franck18/spacefarm/SpaceFarm_RaspberryPi_Dashboard.docx

WORKSHOP HORIZON 2080 · PILIER 2 FOODTECH & AGRITECH

SpaceFarm 2080

Le Raspberry Pi et le tableau de bord

Ce document explique en détail la partie « serveur et affichage » du prototype : comment le Raspberry Pi reçoit, vérifie, enregistre et exploite les mesures de la serre, puis comment le tableau de bord web les présente et permet de piloter l'éclairage.

Il est écrit pour être compris sans connaître le code : chaque notion technique est expliquée simplement, puis illustrée par le vrai fonctionnement du programme.

Périmètre présenté

Mesures réelles : température et humidité de l'air (DHT11), luminosité relative (photorésistance), niveau d'eau (sonde).

Commande réelle : la LED d'éclairage, en automatique ou en manuel.

Simulation uniquement : les trois cultures, leurs besoins en eau et le scénario de crise « Survival Mode ».

Reporté après le rendu : l'irrigation par pompe (le tuyau arrive après la date de rendu).

EPSI Bachelor 3 · Septembre 2026

Sommaire

Si le sommaire est vide : clic droit dessus puis « Mettre à jour les champs ».

# 1. Vue d'ensemble

## 1.1 Le rôle du Raspberry Pi et du tableau de bord

Le prototype SpaceFarm est composé de trois éléments qui travaillent ensemble. Une image simple aide à comprendre qui fait quoi :

Élément | Image simple | Ce qu'il fait réellement
Arduino Yún | Les yeux et les mains | Lit les capteurs toutes les 2 secondes environ, envoie les valeurs au Pi par Wi-Fi et allume ou éteint la LED quand le Pi le demande.
Raspberry Pi 3 | La mémoire et le cerveau | Reçoit les mesures, les vérifie, les enregistre dans une base de données, déclenche les alertes, décide de l'éclairage et héberge le site web.
Tableau de bord | L'écran de contrôle | Page web ouverte dans un navigateur : affiche les mesures, les courbes, les alertes et l'état du Pi, et permet de commander la LED.

Ma partie couvre le Raspberry Pi (le programme serveur écrit en Python et la base de données SQLite) et le tableau de bord (le site écrit en React et TypeScript).

## 1.2 Le chemin complet d'une mesure

1. Le capteur produit une valeur électrique ; l'Arduino Yún la lit.
2. La Yún regroupe toutes ses mesures dans un petit message texte au format JSON et l'envoie au Pi par Wi-Fi (POST /api/ingest).
3. Le Pi vérifie le message, enregistre chaque mesure dans SQLite et regarde si une alerte doit être créée.
4. Le Pi décide si la LED doit changer d'état et glisse l'ordre éventuel dans sa réponse à la Yún.
5. Dans le navigateur, le tableau de bord demande l'état complet au Pi toutes les 3 secondes (GET /api/state).
6. Le tableau de bord vérifie la réponse, puis met à jour les cartes, les courbes et le journal.

Point clé

Tout fonctionne en réseau local, sans Internet ni service cloud. C'est essentiel dans le contexte du sujet : un vaisseau spatial ne peut pas compter sur une connexion permanente avec la Terre.

## 1.3 Pourquoi deux cartes plutôt qu'une seule ?

- La Yún est faite pour lire des broches électriques (capteurs) et piloter des sorties (LED). Elle a très peu de mémoire.
- Le Pi est un vrai petit ordinateur sous Linux : il peut stocker des jours de mesures, faire tourner un serveur web et calculer des statistiques.
- Chacun fait ce qu'il fait le mieux. Le navigateur ne lit jamais directement les capteurs : il passe toujours par le Pi.

# 2. Le Raspberry Pi

## 2.1 Le matériel et le système

Élément | Valeur
Modèle | Raspberry Pi 3 Model B Rev 1.2
Système | Raspbian GNU/Linux 11 (bullseye)
Réseau | Wi-Fi du lycée ; adresse vérifiée 192.168.41.88 (attribuée par DHCP, elle peut changer)
Port du service | 8000 — adresse du site : http://192.168.41.88:8000/
Emplacement du code | /home/pi/spacefarm/backend/ (serveur) et /home/pi/spacefarm/frontend/dist/ (site compilé)
Base de données | /var/lib/spacefarm/spacefarm.db

## 2.2 Organisation du code du serveur

Le serveur est écrit en Python avec uniquement la bibliothèque standard : http.server pour le web et sqlite3 pour la base. Aucun framework (comme Flask ou Django) n'est nécessaire, ce qui rend l'installation très simple et le programme léger pour un Raspberry Pi 3.

Fichier | Lignes | Rôle
server.py | 54 | Point de départ : lit les options, prépare la base, lance la purge automatique et démarre le serveur web.
routes.py | 272 | Reçoit toutes les requêtes HTTP et choisit quoi faire selon l'adresse demandée. Construit aussi l'état complet envoyé au site.
db.py | 402 | Tout ce qui touche à la base : vérification des mesures, enregistrement, alertes, historique, purge.
automation.py | 72 | Décision automatique de la LED et gestion du mode automatique / manuel.
commands.py | 109 | File d'attente des ordres envoyés à la Yún, avec expiration et accusé de réception.
calibration.py | 30 | Conversion des valeurs brutes des capteurs (0 à 1023) en pourcentages.
system_info.py | 36 | Lecture de l'état du Pi : température du processeur, mémoire, durée de fonctionnement.
spacefarm.service | — | Fichier de configuration pour que Linux démarre le serveur tout seul.
test_*.py | 400 | 31 tests automatiques du serveur.

## 2.3 Le démarrage automatique avec systemd

systemd est le gestionnaire de services de Linux : c'est lui qui lance les programmes au démarrage de la machine. Le fichier spacefarm.service lui indique comment lancer SpaceFarm :

ExecStart=/usr/bin/python3 -B /home/pi/spacefarm/backend/server.py --host 0.0.0.0 --port 8000

User=pi

Restart=on-failure

RestartSec=5

StateDirectory=spacefarm

ProtectSystem=strict

ProtectHome=read-only

- Démarrage automatique : dès que le Pi est allumé et le réseau prêt, le serveur démarre, sans que personne ait besoin de taper une commande.
- Redémarrage en cas de panne : si le programme plante, systemd le relance au bout de 5 secondes (Restart=on-failure).
- Utilisateur limité : le service tourne sous l'utilisateur pi, pas en administrateur.
- Protection du système : le service ne peut écrire que dans son propre dossier /var/lib/spacefarm. Le reste du système et le dossier personnel sont en lecture seule pour lui.
- --host 0.0.0.0 signifie « accepter les connexions venant du réseau », pas seulement du Pi lui-même. C'est ce qui permet à la Yún et aux navigateurs de le joindre.

## 2.4 Les réglages du serveur

Au lancement, server.py accepte plusieurs options. Les valeurs par défaut utilisées sont les suivantes :

Option | Valeur | Signification
--port | 8000 | Port d'écoute du serveur web.
--db | /var/lib/spacefarm/spacefarm.db | Fichier de la base SQLite.
--stale | 120 s | Au-delà de 2 minutes sans nouvelle valeur, une mesure est considérée comme indisponible.
--retention | 7 jours | Durée de conservation des mesures.
--history-hours | 6 h | Durée de l'historique envoyé au tableau de bord.
--reservoir | 0,05 L | Capacité configurée du réservoir (50 mL), utilisée pour estimer un volume.
--token | vide | Mot de passe optionnel exigé de la Yún. Vide = pas de contrôle (voir limites).

Le serveur est multithread (ThreadingHTTPServer) : il peut répondre à la Yún et à plusieurs navigateurs en même temps sans que l'un bloque l'autre.

## 2.5 La réception d'une mesure, étape par étape

Environ toutes les 2 secondes, la Yún envoie ce message au Pi (valeurs réelles relevées le 24 septembre 2026) :

POST /api/ingest

{ "sensor": "spacefarm-yun",

"ack": 0,

"readings": {

"temperature": 23.9,

"humidity": 58,

"light_raw": { "value": 481, "unit": "ADC" },

"water_raw": { "value": 0, "unit": "ADC" },

"lighting": 0 } }

La fonction _receive_measurements() de routes.py traite ce message dans cet ordre :

1. Lire le message (_read_json) : le message doit être du JSON valide et ne pas dépasser 64 Ko.
2. Vérifier l'autorisation (_authorised) : si un jeton est configuré, il doit correspondre. Aujourd'hui aucun jeton n'est configuré.
3. Vérifier le contenu (db.parse_payload) : nom du capteur, liste des mesures, valeurs numériques et plausibles.
4. Enregistrer (db.store_readings) : une ligne par mesure dans SQLite, et création des alertes si une valeur franchit un seuil.
5. Confirmer l'ordre précédent (commands.confirm) : le champ ack indique quel ordre la Yún a déjà appliqué.
6. Décider pour la LED (automation.reconcile) : faut-il allumer ou éteindre ?
7. Répondre avec le code 201 (« créé ») et, si besoin, un ordre pour la Yún.

Exemple de réponse du Pi quand il faut allumer la LED :

{ "command": "lighting 1 42", "status": "ok", "sensor": "spacefarm-yun", "stored": 5, "alerts": [] }

lighting 1 42 se lit : « allume la LED (1), c'est l'ordre numéro 42 ». La Yún applique l'ordre puis renvoie ack: 42 dans son message suivant. Le Pi sait alors que l'ordre a bien été exécuté.

Pourquoi l'ordre voyage dans la réponse ?

C'est toujours la Yún qui contacte le Pi, jamais l'inverse. Le Pi profite donc de sa réponse pour transmettre les ordres. Cela évite d'avoir à installer un second serveur sur la Yún ou un système de messagerie comme MQTT.

## 2.6 La vérification des données

Un principe guide tout le serveur : mieux vaut afficher « mesure indisponible » qu'une valeur fausse présentée comme vraie. Plusieurs contrôles l'appliquent :

Contrôle | Ce qui se passe
Message trop gros (> 64 Ko) ou JSON illisible | Refus avec le code 400 et un message d'erreur clair.
Nom de capteur ou de mesure invalide | Refus. Les noms sont contrôlés par une expression régulière : lettres minuscules, chiffres et _ uniquement, 32 caractères maximum.
Plus de 32 mesures dans un même envoi | Refus.
Valeur non numérique (texte, vrai/faux, infini) | Refus du message entier.
Valeur null (le capteur n'a pas répondu) | Enregistrée avec la qualité error : c'est un capteur en panne, pas un zéro.
Valeur physiquement impossible | Enregistrée mais marquée error, donc jamais affichée comme vraie.
Heure absurde (carte sans horloge) | L'heure du Pi remplace celle du message.

Plages physiquement possibles acceptées (PLAUSIBLE_RANGE, adaptées au DHT11) :

Mesure | Plage acceptée
Température | 0 à 50 °C
Humidité de l'air | 20 à 80 %
Niveau d'eau | 0 à 100 %

## 2.7 La base de données SQLite

SQLite est une base de données contenue dans un seul fichier. Elle ne nécessite aucun serveur séparé : c'est idéal pour un Raspberry Pi. Elle contient cinq tables :

Table | Contenu | Exemple
readings | Une ligne par mesure : capteur, nom de la mesure, valeur, unité, qualité, heure de mesure, heure de réception. | spacefarm-yun · temperature · 23,9 · °C · ok
events | Le journal : alertes, retours à la normale, ordres confirmés, démarrage du service. | « temperature hors plage · 6,5 °C »
commands | Les ordres pour la Yún : créé, livré, confirmé, date d'expiration. | lighting · 1 · livré · confirmé
sensors | Les cartes connues, avec la date du premier et du dernier envoi. | spacefarm-yun · vu il y a 2 s
meta | Réglages : version du schéma, mode d'éclairage, consigne manuelle. | lighting_mode = automatic

### Choix techniques de la base

- Index sur la mesure et l'heure : retrouver « la dernière température » est immédiat, même avec des milliers de lignes.
- Mode WAL (journal d'écriture anticipée) : on peut lire la base pendant qu'on y écrit. Le site n'est donc jamais bloqué par l'arrivée d'une mesure.
- Transactions : toutes les mesures d'un même envoi sont enregistrées ensemble, ou pas du tout en cas d'erreur. La base ne reste jamais à moitié remplie.
- Requêtes paramétrées : les valeurs reçues ne sont jamais collées directement dans le texte SQL, ce qui empêche l'injection SQL.

### La purge automatique

Une carte microSD a une capacité limitée et s'use avec les écritures. Toutes les heures, un fil d'exécution séparé supprime les mesures de plus de 7 jours et ne garde que les 500 derniers événements du journal. Si la purge échoue, le serveur continue de fonctionner et l'erreur est notée dans les journaux.

### L'historique allégé

Avec une mesure toutes les 2 secondes, 6 heures représentent plus de 10 000 lignes par mesure. Le Pi ne les envoie pas toutes : la fonction history() découpe la période en 180 tranches et calcule directement en SQL la moyenne de chaque tranche. Le navigateur reçoit 180 points, suffisants pour une courbe lisible, et le Pi travaille beaucoup moins.

### Les mesures périmées

Si une mesure a plus de 120 secondes, latest_measurements() la déclare indisponible (qualité error, valeur masquée). Ainsi, si la Yún s'arrête, le site n'affiche pas indéfiniment la dernière valeur comme si elle était actuelle.

## 2.8 Les alertes

À chaque enregistrement, le Pi compare les mesures à leur plage normale (NOMINAL_RANGE) :

Mesure | Plage normale | Remarque
Température | 18 à 28 °C | Plage choisie pour les cultures du prototype.
Humidité de l'air | 45 à 75 % | Humidité de l'air, pas du sol.
Niveau d'eau | 20 % et plus | En dessous de 15 %, le site passe en CRITIQUE.

Une alerte n'est écrite qu'au moment où la valeur franchit la limite, pas à chaque mesure. Sinon le journal recevrait la même ligne toutes les 2 secondes. Quand la valeur revient dans la plage, un message « revenu dans la plage nominale » est ajouté.

10:29 ⚠ temperature hors plage · 6.5 °C (attendu 18.0–28.0)

10:29 ✓ temperature revenu dans la plage nominale · 25.4 °C

## 2.9 La conversion en pourcentages

La photorésistance et la sonde d'eau donnent une valeur brute entre 0 et 1023 (c'est la sortie du convertisseur analogique-numérique de l'Arduino, appelé ADC). Ce nombre ne parle à personne : calibration.py le transforme en pourcentage.

Mesure | Repères relevés | Formule | Exemple
Luminosité | 1015 = capteur couvert (noir) ; 220 = éclairage de référence | 100 × (brut − 1015) / (220 − 1015) | brut 481 → 67 %
Niveau d'eau | 0 = sonde sèche ; 717 = profondeur de référence | 100 × brut / 717 | brut 0 → 0 %

- Le résultat est toujours borné entre 0 et 100 %. Une valeur brute hors de 0 à 1023 est rejetée.
- La luminosité est un indice relatif, pas des lux. Pour afficher des lux, il faudrait étalonner le capteur avec un luxmètre.
- Le niveau d'eau est une estimation qui dépend de la profondeur à laquelle la sonde est plongée. Le volume affiché (sur 50 mL) en découle.
- Le Pi garde toujours la valeur brute dans la base : si l'étalonnage change, l'historique reste exploitable.

## 2.10 L'automatisation de la LED

### La règle des deux seuils

Sur ce capteur, plus il fait sombre, plus la valeur brute est grande. Le Pi applique la règle suivante (automation.py) :

LIGHT_ON_RAW = 650 # au-dessus : il fait sombre -> allumer

LIGHT_OFF_RAW = 450 # en dessous : il fait clair -> éteindre

desired = 1 if raw >= 650 else 0 if raw <= 450 else current

Entre 450 et 650, on garde l'état actuel. Cette technique s'appelle une hystérésis. Avec un seul seuil, par exemple 550, une lumière qui oscille entre 549 et 551 ferait clignoter la LED sans arrêt. Avec deux seuils, il faut un vrai changement de luminosité pour changer d'état.

### Mode automatique et mode manuel

- Automatique : le Pi décide à chaque mesure reçue selon la règle ci-dessus.
- Manuel : le bouton « Éclairage » du site fixe la LED sur ON ou OFF. Lors du passage en manuel, l'état actuel de la LED est conservé : rien ne bascule brusquement.
- Le mode et la consigne sont enregistrés dans la table meta : ils sont conservés après un redémarrage du Pi.
- La décision est prise sur le Pi, pas dans le navigateur : l'éclairage automatique continue même si personne n'a ouvert le site.

### La file d'ordres (`commands.py`)

1. Le Pi crée un ordre (par exemple « allumer ») avec un numéro unique et une durée de vie de 15 secondes.
2. Si un nouvel ordre vise la même LED, l'ancien ordre non livré est annulé : seul le dernier compte.
3. À la prochaine mesure de la Yún, l'ordre est placé dans la réponse et marqué « livré ». Il n'est livré qu'une seule fois.
4. La Yún applique l'ordre puis renvoie son numéro dans ack. Le Pi le marque « confirmé » et écrit dans le journal : « ordre 75 exécuté, éclairage éteint ».
5. Un ordre non livré au bout de 15 secondes expire. Il ne sera pas appliqué plus tard par surprise.

Vérifié sur le prototype

Test du 23 septembre 2026 sur le vrai montage : capteur couvert → valeur brute élevée → ordre d'allumage → LED allumée. Capteur découvert → valeur basse → LED éteinte. En mode manuel, ON puis OFF depuis le site, avec accusés de réception visibles dans le journal.

## 2.11 L'état complet envoyé au site

La fonction snapshot() de routes.py construit la réponse de GET /api/state. Elle rassemble en un seul objet tout ce dont le site a besoin :

Partie | Contenu
measurements | Les 4 mesures (température, humidité, lumière en %, eau en %), chacune avec sa valeur, sa qualité et son heure.
mode et lighting | Mode automatique ou manuel, et état actuel de la LED tel que la Yún l'a renvoyé.
reservoirLiters | Volume d'eau estimé à partir du niveau et de la capacité de 50 mL.
system | Modèle du Pi, système, température du processeur, mémoire utilisée, durée de fonctionnement, commandes disponibles ou non.
history | Les points de courbe des 6 dernières heures, déjà convertis en %.
events | Les 40 derniers événements du journal.
pump | Toujours vide (null) : aucune pompe n'est branchée.

Les informations système sont lues directement dans les fichiers de Linux : /proc/uptime (durée de fonctionnement), /sys/class/thermal/thermal_zone0/temp (température du processeur), /proc/meminfo (mémoire). Attention : la température du processeur du Pi n'a rien à voir avec la température de la serre.

## 2.12 Les adresses de l'API

Une API est une liste d'adresses auxquelles un programme peut envoyer des demandes. Celle du Pi :

Méthode et adresse | Qui l'utilise | Rôle
GET /api/health | Vérification | Répond status: ok, service: spacefarm, version 0.3.0. Sert à vérifier que c'est bien le bon Pi.
GET /api/state | Tableau de bord | État complet affiché par le site (voir 2.11).
GET /api/history | Vérification | Historique réglable : durée (jusqu'à 7 jours), nombre de points, mesure choisie.
GET /api/metrics | Vérification | Dernières valeurs de toutes les mesures, y compris brutes (ADC).
GET /api/sensors | Vérification | Cartes connues, en ligne ou hors ligne.
GET /api/stats | Vérification | Nombre de mesures, de capteurs, plus ancienne et plus récente mesure.
POST /api/ingest | Arduino Yún | Réception des mesures et renvoi d'un ordre éventuel.
POST /api/mode | Tableau de bord | {"mode":"automatic"} ou {"mode":"manual"}.
POST /api/actuators | Tableau de bord | En manuel : {"actuator":"lighting","enabled":true}. Seule la LED est acceptée : une demande de pompe est refusée.

Toute autre adresse sert les fichiers du site compilé (frontend/dist). Le Pi est donc à la fois l'API et l'hébergeur du site : un seul programme, une seule adresse.

## 2.13 Robustesse et sécurité

Situation | Réaction du serveur
La base échoue pendant un enregistrement | Réponse 500 à la Yún ; le serveur ne s'arrête pas.
Erreur pendant le traitement des ordres | Les mesures sont déjà enregistrées ; l'ordre attendra la mesure suivante.
Le programme plante | systemd le relance en 5 secondes.
Demande d'un fichier hors du dossier du site (ex. ../../etc/passwd) | Refus 404 : le chemin est vérifié pour rester dans le dossier du site.
Commande de la LED alors que la Yún ne donne plus son état | Refus 409 « LED de la Yún indisponible ».
Jeton configuré | Comparaison à temps constant (hmac.compare_digest) pour ne rien laisser deviner.

En-têtes de sécurité ajoutés à chaque réponse : Cache-Control: no-store (toujours des données fraîches), X-Content-Type-Options: nosniff et Referrer-Policy: same-origin.

Limite à annoncer honnêtement

Aujourd'hui, aucun jeton n'est configuré et les boutons du site ne demandent pas de mot de passe : tout appareil du réseau local peut lire les mesures et commander la LED. C'est acceptable pour une démonstration, mais c'est la première amélioration prévue (« protéger les commandes du site »).

# 3. Le tableau de bord

## 3.1 Les technologies et leur utilité

Outil | À quoi il sert | Pourquoi ce choix
React 19 | Construire l'interface en petits blocs réutilisables (composants). | Chaque panneau est indépendant, facile à modifier et à tester.
TypeScript | JavaScript avec des types vérifiés avant l'exécution. | Beaucoup d'erreurs sont détectées à la compilation plutôt que devant le jury.
Vite | Serveur de développement et compilation du site. | Très rapide ; produit un dossier dist léger que le Pi sert directement.
Recharts | Dessiner les courbes de l'historique. | Courbes interactives avec infobulles.
Zod | Vérifier le format des données reçues du Pi. | Une réponse incorrecte est rejetée au lieu d'afficher des valeurs fausses.
Lucide | Icônes (thermomètre, goutte, soleil…). | Icônes légères et cohérentes.
Fontsource | Polices Inter et Space Grotesk incluses dans le site. | Le site s'affiche correctement sans Internet.
Vitest | Tests automatiques. | Vérifie les règles de calcul et le format des données.

## 3.2 Organisation du code

Fichier | Rôle
src/App.tsx | Assemble tous les panneaux et calcule l'état global NORMAL / ATTENTION / CRITIQUE.
src/hooks/useSpaceFarm.ts | Demande les données toutes les 3 s, envoie les commandes, détecte la perte de connexion.
src/data/provider.ts | Choisit la source : le vrai Pi (API) ou la simulation (démo).
src/data/types.ts | Définit le format attendu des données avec Zod, les unités et les plages normales.
src/data/engine.ts | Moteur de la simulation (mode démo uniquement).
src/components/MetricCards.tsx | Les 4 cartes de mesure.
src/components/HistoryPanel.tsx | Les courbes et les statistiques.
src/components/ControlPanel.tsx | Mode automatique / manuel et bouton de la LED.
src/components/SystemPanel.tsx | État du Raspberry Pi et des capteurs.
src/components/WaterPanel.tsx | Volume d'eau estimé et autonomie.
src/components/EventLog.tsx | Le journal de bord.
src/components/CulturesPanel.tsx, CrisisPanel.tsx | Cultures et scénario de crise (simulation).

## 3.3 La récupération des données

Le fichier useSpaceFarm.ts fait tourner une boucle simple :

1. Toutes les 3 secondes, il demande GET /api/state au Pi.
2. Une seule requête à la fois : si la précédente n'est pas finie, on attend. Cela évite d'empiler les demandes si le réseau est lent.
3. Chaque requête est abandonnée après 5 secondes sans réponse.
4. Si aucune donnée fraîche n'est arrivée depuis plus de 10 secondes, le site considère la connexion comme perdue.
5. L'âge des données est calculé avec l'horloge de l'ordinateur qui affiche le site, pour détecter une coupure même si l'horloge du Pi est décalée.

## 3.4 La vérification des données avec Zod

Le site et le Pi partagent un contrat de données : la liste exacte des champs attendus, leur type et leurs limites. Il est écrit dans types.ts :

const reading = z.object({

value: z.number().finite().nullable(),

quality: z.enum(['ok', 'error', 'stale']),

observedAt: z.string().datetime(),

});

- Si la réponse du Pi ne respecte pas ce contrat, elle est refusée et un message d'erreur s'affiche.
- Si une réponse ne se déclare pas comme données réelles (source: "live"), elle est aussi refusée : on ne peut pas confondre démo et réel.
- En cas d'erreur, le site ne bascule jamais tout seul vers des données simulées. Il réessaie toutes les 3 secondes.

## 3.5 Données réelles ou démonstration

Adresse | Source | Effet
http://192.168.41.88:8000/?source=api | Le vrai Raspberry Pi | Mesures réelles, historique SQLite, commande réelle de la LED. Badge « Raspberry Pi ».
http://192.168.41.88:8000/?source=mock | Simulation dans le navigateur | Aucun contact avec le Pi ni avec le matériel. Badge « Simulation » et bandeau « Données et équipements simulés ».

Un lien en haut à droite (« Mode démo » / « Connecter au Pi ») permet de passer de l'un à l'autre. Cette séparation est volontaire : le jury voit toujours clairement ce qui est mesuré et ce qui est simulé.

## 3.6 L'écran, zone par zone

Figure 1 — Tableau de bord réel, relié au Raspberry Pi (capture du 24/09/2026)

Figure 1 — Tableau de bord réel, relié au Raspberry Pi (capture du 24/09/2026)

### Les quatre cartes de mesure

- Température et humidité de l'air (DHT11), luminosité relative et réservoir en %.
- Chaque carte affiche la valeur, une mini-courbe et un état : « Dans la plage cible », « À surveiller »…
- Si la mesure est absente ou périmée, la valeur est remplacée par « — » au lieu d'un faux chiffre.
- Cliquer sur une carte affiche sa courbe dans le panneau Historique.

### Évolution des mesures (historique)

- Courbe de la mesure choisie sur 1 h, 6 h ou 24 h, avec infobulle au survol.
- Statistiques sous la courbe : minimum, moyenne et maximum.
- En mode réel, ce sont les données de la base SQLite du Pi. Ce panneau est chargé à la demande pour que la page s'ouvre plus vite.

### Automatisation

- Boutons Automatique / Manuel. En manuel, l'interrupteur Éclairage commande la LED.
- La ligne Pompe est grisée avec la mention « Pompe non branchée ».
- Les boutons sont désactivés si la connexion est perdue, si une commande est en cours, ou si la Yún ne donne plus l'état de la LED. Un texte explique toujours pourquoi.

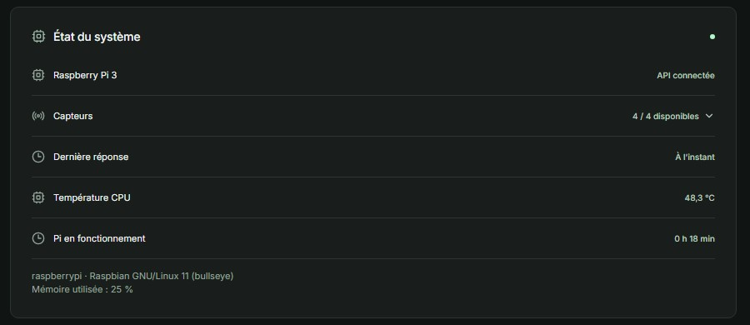
[picture p7: figure]
Figure 2 — Panneau « État du système »

Figure 2 — Panneau « État du système »

### État du système

- Connexion à l'API, nombre de capteurs disponibles (4 / 4), heure de la dernière réponse.
- Température du processeur du Pi, mémoire utilisée, durée de fonctionnement, version du système.

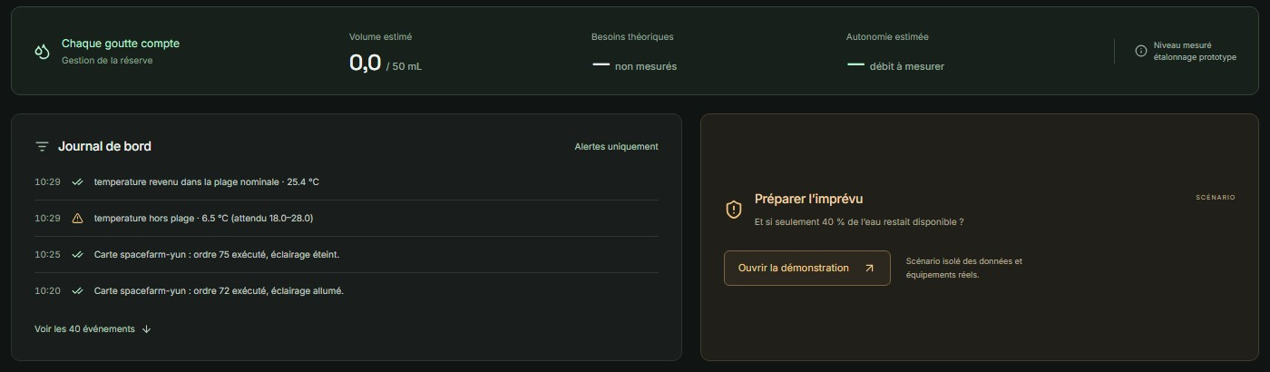
[picture p8: figure]
Figure 3 — Réserve d'eau, journal de bord et accès au scénario de crise

Figure 3 — Réserve d'eau, journal de bord et accès au scénario de crise

### Réserve d'eau (« Chaque goutte compte »)

- Volume estimé sur la capacité configurée de 50 mL.
- L'autonomie affiche « débit à mesurer » : sans mesure réelle de la consommation, on refuse d'inventer une durée.

### Journal de bord

- Alertes de seuil, retours à la normale, ordres exécutés (« ordre 75 exécuté, éclairage éteint »).
- Filtre « Alertes uniquement » et bouton pour voir les 40 derniers événements.

### Cultures et scénario de crise — simulation

- Le panneau Les cultures présente trois profils théoriques (laitue, basilic, tomate) et leurs besoins en eau. Ils ne sont pas mesurés.
- Le panneau Préparer l'imprévu ouvre la démonstration du Survival Mode : réserve à 40 %, laitue protégée, basilic réduit, tomate en pause. Il n'a aucun effet sur le matériel.

## 3.7 L'état global NORMAL / ATTENTION / CRITIQUE

En haut à droite, un voyant résume la situation. Il est calculé dans App.tsx :

État | Condition | Message affiché
CRITIQUE (rouge) | Réservoir en dessous de 15 % | « Réserve d'eau critique »
ATTENTION (orange) | Une mesure hors de sa plage normale | « Conditions à surveiller »
ATTENTION (orange) | Un capteur absent, en erreur ou en retard de plus de 10 s | « Capteurs à brancher ou à vérifier »
ATTENTION (orange) | Connexion au Pi perdue | « Flux interrompu · dernières valeurs conservées »
NORMAL (vert) | Aucun des cas ci-dessus | « Conditions mesurées favorables »

Un seul message est affiché : le plus prioritaire. L'utilisateur sait immédiatement quoi regarder en premier.

## 3.8 Que se passe-t-il en cas de panne ?

Panne | Ce que voit l'utilisateur
Le Wi-Fi ou le Pi ne répond plus | Bandeau rouge « Données périmées. Les commandes sont désactivées. » ; nouvelles tentatives automatiques toutes les 3 s.
La Yún ne transmet plus | Après 2 minutes, les mesures passent en « — » ; l'état devient ATTENTION ; le bouton de la LED est bloqué.
Un capteur renvoie une valeur invalide | La carte concernée affiche « — » ; l'historique n'utilise que les valeurs valides.
Le Pi refuse une commande | Message d'erreur explicite, que l'on peut fermer.
Le site ne peut pas se connecter au démarrage | Écran « Connexion au service impossible », sans basculer vers la simulation.

Pendant une panne réseau, la LED garde son dernier état : elle ne reçoit plus d'ordre du Pi tant que la connexion n'est pas revenue.

## 3.9 Le mode démonstration

Le fichier engine.ts simule une serre complète dans le navigateur, pour présenter les fonctions même sans matériel :

- Un historique synthétique de 24 h et des mesures qui évoluent légèrement toutes les 3 secondes.
- Des cycles de pompe fictifs en automatique (8 s toutes les 120 s) et une pompe manuelle limitée à 10 s. Aucune pompe réelle ne tourne.
- Le scénario de crise : réserve réduite à 40 %, allocations prioritaires, calcul d'un objectif de 48 h.
- Un bouton « Tester une coupure » pour montrer le comportement en cas de perte de connexion.

## 3.10 Compilation et mise en ligne

cd frontend

npm install # installe les dépendances (une seule fois)

npm test # lance les tests

npm run build # vérifie TypeScript puis crée le dossier dist/

Le dossier dist/ (fichiers HTML, JavaScript, CSS et polices) est copié sur le Pi dans /home/pi/spacefarm/frontend/dist/. Le serveur Python le sert directement : il n'y a pas besoin d'un serveur web supplémentaire comme Apache ou Nginx.

# 4. Tests et vérifications

## 4.1 Tests automatiques

Fichier | Nombre | Ce qui est vérifié
backend/test_server.py | 21 | Chaîne complète mesure → base → tableau de bord ; valeurs nulles traitées comme pannes ; valeurs impossibles marquées ; mesures périmées ; alerte émise une seule fois au franchissement ; messages refusés ; noms de mesure non injectables ; heure absurde recalée ; purge ; LED automatique et manuelle ; jeton.
backend/test_calibration.py | 7 | Conversions lumière et eau en %, bornes, valeurs invalides.
backend/test_ai_proxy.py | 3 | Relais de l'assistant (fonction facultative).
frontend/src/data/engine.test.ts | 8 | Règles de la simulation et budget d'eau.
frontend/src/data/types.test.ts | 3 | Contrat des données (Zod).

Commandes pour les lancer :

python -B -m unittest discover -s backend -v

cd frontend && npm test && npm run build

## 4.2 Vérifications sur le vrai matériel

- 24/09/2026 : /api/health répond spacefarm, version 0.3.0 ; /api/state contient des mesures fraîches ; la carte spacefarm-yun est en ligne.
- 23/09/2026 : LED automatique testée en couvrant et découvrant le capteur ; LED manuelle ON puis OFF depuis le site ; accusés de réception visibles dans le journal.

## 4.3 Commandes utiles pendant la présentation

Depuis un PC Windows du même réseau (PowerShell) :

Invoke-RestMethod http://192.168.41.88:8000/api/health

Invoke-RestMethod http://192.168.41.88:8000/api/state

Invoke-RestMethod http://192.168.41.88:8000/api/metrics

Sur le Pi, par SSH :

systemctl status spacefarm.service # le service tourne-t-il ?

journalctl -u spacefarm.service -n 50 --no-pager # 50 dernières lignes du journal

ls -lh /var/lib/spacefarm/spacefarm.db # taille de la base

# 5. Limites et améliorations

## 5.1 Limites actuelles

Limite | Explication
Pas de protection des commandes | Aucun mot de passe sur le site ni jeton pour la Yún : tout appareil du réseau local peut commander la LED.
Adresse IP variable | 192.168.41.88 est donnée par le réseau du lycée et peut changer. Elle est aussi écrite dans le code de la Yún.
Étalonnages provisoires | Luminosité en % relatif (pas en lux) ; niveau d'eau estimé selon la profondeur de la sonde.
Irrigation reportée | Pas de pompe branchée ni de mesure de débit : l'autonomie réelle en eau ne peut pas être calculée.
Pas de connexion chiffrée | Le site utilise HTTP simple, suffisant en réseau local mais pas sur un réseau ouvert.

## 5.2 Éléments visibles sur le site mais hors du périmètre présenté

Pour rester cohérent avec le diaporama, ces éléments doivent être présentés comme « prévus » ou retirés de l'écran avant la démonstration :

- Le panneau « Croissance et aération » (distance à la plante, hauteur estimée, trappe, ventilateur) : ces capteurs et actionneurs ne font plus partie du rendu.
- Le panneau « Assistant SpaceFarm » : fonction facultative qui dépend d'un PC et d'une connexion ; elle ne pilote rien.
- Le bandeau d'information en mode réel affiche encore un ancien texte (« Mesures de culture indisponibles tant que les capteurs ne sont pas configurés »), alors que les mesures arrivent bien. Il faut le corriger dans frontend/src/App.tsx.

## 5.3 Améliorations prévues

1. Protéger les commandes : activer le jeton pour la Yún (l'option --token existe déjà) et ajouter un code d'accès aux boutons du site.
2. Étalonner la lumière (avec un luxmètre) et le niveau d'eau (plusieurs volumes connus dans le vrai réservoir).
3. Préciser les alertes et leurs seuils selon les besoins réels des plantes.
4. Fixer l'adresse du Pi (IP réservée ou nom local fiable).
5. Documenter le montage et l'installation.
6. Après le rendu : brancher la pompe avec ses sécurités et mesurer le débit, pour calculer une vraie autonomie en eau.

# 6. Questions possibles du jury

Pourquoi un Raspberry Pi en plus de l'Arduino ?

L'Arduino lit les capteurs mais a très peu de mémoire. Le Pi est un ordinateur complet : il stocke des jours de mesures, héberge le site et prend les décisions. Chacun fait ce qu'il sait bien faire.

Pourquoi SQLite et pas MySQL ou PostgreSQL ?

SQLite tient dans un seul fichier, sans serveur à installer ni à surveiller. Pour un seul Pi et quelques mesures par seconde, c'est largement suffisant et plus fiable.

Pourquoi HTTP et pas MQTT ?

Avec une seule carte et un seul Pi, HTTP est plus simple à installer et à déboguer. MQTT deviendrait intéressant avec de nombreuses serres.

Pourquoi la LED est-elle décidée par le Pi et pas par le site ?

Pour que l'automatisation fonctionne même quand personne n'a ouvert le site. Le navigateur n'est qu'un écran de contrôle.

Pourquoi deux seuils (450 et 650) ?

Pour éviter que la LED clignote quand la lumière est proche de la limite. C'est une hystérésis, comme dans un thermostat.

67 % de lumière, cela fait combien de lux ?

On ne peut pas le dire : c'est un indice relatif entre « capteur couvert » et « éclairage de référence ». Il faudrait un étalonnage avec un luxmètre.

Que se passe-t-il si le Wi-Fi tombe ?

Le site affiche « Données périmées » et bloque les commandes. Le Pi continue de fonctionner. La LED garde son dernier état. Quand le réseau revient, tout reprend automatiquement.

Que se passe-t-il si le Pi redémarre ?

systemd relance le service automatiquement. La base, le mode d'éclairage et la consigne manuelle sont conservés sur la carte SD.

La carte SD ne va-t-elle pas se remplir ?

Non : les mesures de plus de 7 jours et les événements au-delà de 500 sont supprimés automatiquement toutes les heures.

Comment savez-vous que la LED s'est vraiment allumée ?

La Yún renvoie le numéro de l'ordre appliqué (accusé de réception) et l'état de la LED dans sa mesure suivante. Le journal l'affiche.

Comment évitez-vous d'afficher de fausses valeurs ?

Les valeurs impossibles sont marquées en erreur, les mesures de plus de 2 minutes sont déclarées indisponibles, et le site vérifie chaque réponse avec Zod.

Le système est-il sécurisé ?

Il est protégé contre les messages malformés, l'injection SQL et l'accès aux fichiers hors du site. En revanche, les commandes ne sont pas encore protégées par mot de passe : c'est la prochaine amélioration.

Le Survival Mode agit-il sur la serre ?

Non. C'est une simulation pour montrer comment prioriser les cultures en cas de pénurie. Elle est clairement étiquetée « Simulation ».

# Annexe — Glossaire

Terme | Définition simple
ADC | Convertisseur analogique-numérique : transforme une tension électrique en nombre de 0 à 1023.
API | Liste d'adresses auxquelles un programme peut envoyer des demandes et recevoir des réponses.
Accusé de réception (ack) | Message qui confirme qu'un ordre a bien été reçu et appliqué.
Base de données | Endroit organisé où l'on range les données pour les retrouver rapidement.
Composant (React) | Morceau d'interface indépendant, par exemple une carte de mesure.
DHCP | Service du réseau qui donne automatiquement une adresse IP à chaque appareil.
Hystérésis | Utiliser deux seuils différents pour allumer et éteindre, afin d'éviter les basculements répétés.
HTTP | Protocole utilisé par le web pour échanger des demandes et des réponses.
JSON | Format de texte simple pour écrire des données : {"temperature": 23.9}.
Polling | Demander régulièrement les nouvelles données (ici toutes les 3 secondes).
SQLite | Base de données contenue dans un seul fichier, sans serveur séparé.
systemd | Programme de Linux qui démarre et surveille les services.
TypeScript | JavaScript avec vérification des types.
Zod | Bibliothèque qui vérifie que des données respectent un format attendu.

SpaceFarm 2080 · Raspberry Pi et tableau de bord
