franck18/spacefarm/drive-download-20260924T081925Z-1-001/0F199E2D-5E54-4167-9A8A-3AAB4F7EBB38.PNG

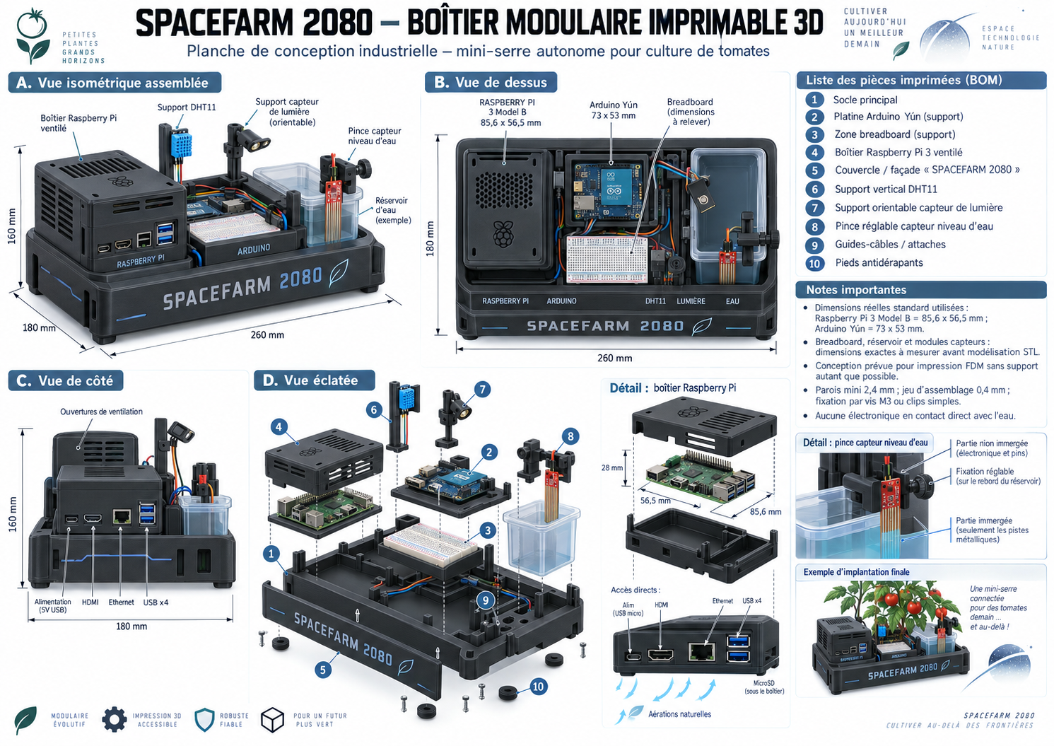
drive-download-20260924T081925Z-1-001/0F199E2D-5E54-4167-9A8A-3AAB4F7EBB38.PNG
