franck18/spacefarm/drive-download-20260924T081925Z-1-001/460AA19E-D21F-4DA5-A54E-3017DBAB8CE7.PNG

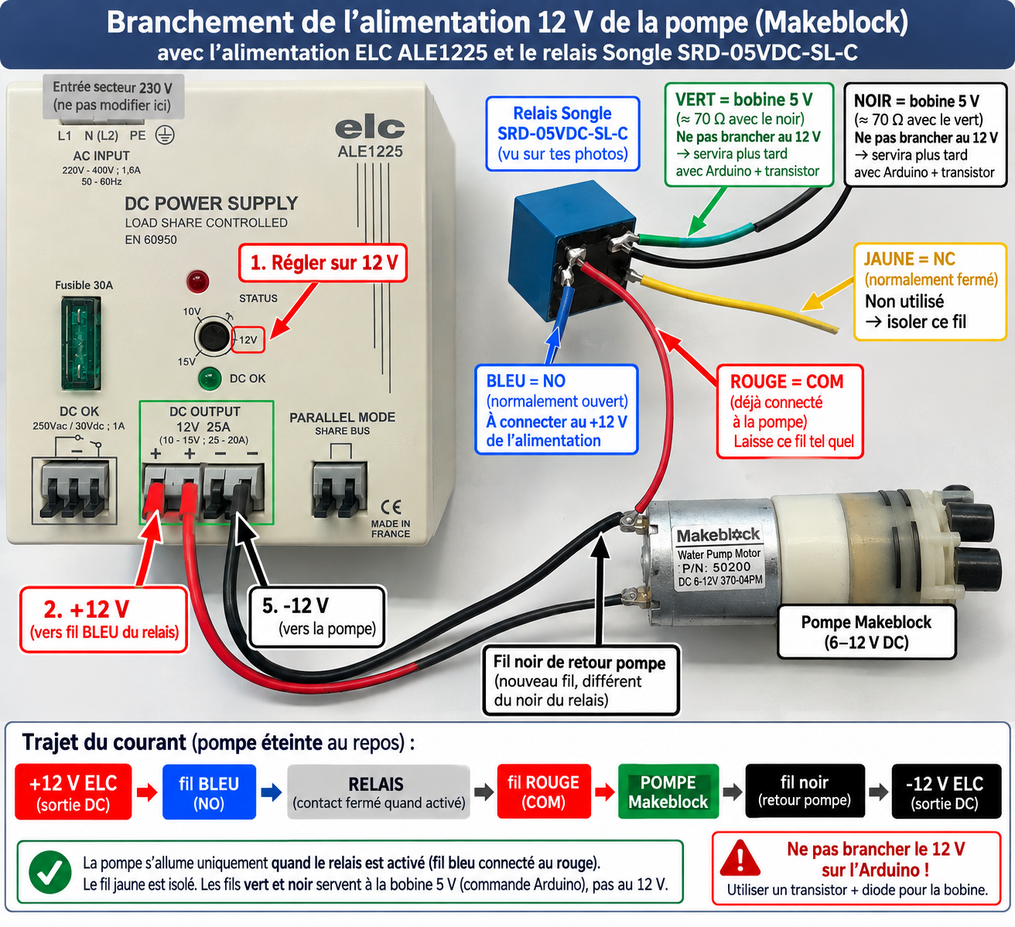
drive-download-20260924T081925Z-1-001/460AA19E-D21F-4DA5-A54E-3017DBAB8CE7.PNG
