franck18/spacefarm/drive-download-20260924T081925Z-1-001/A95D6457-891D-46A8-988D-1FC77627E06A.PNG

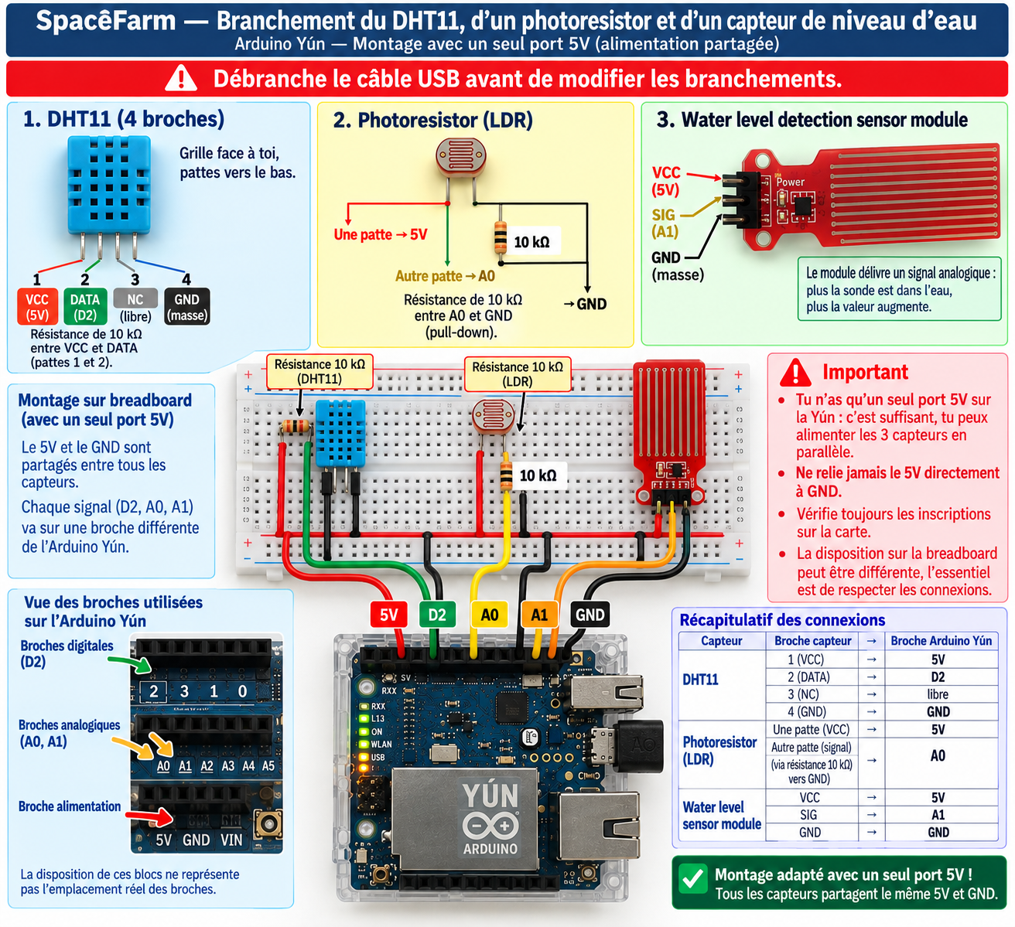
drive-download-20260924T081925Z-1-001/A95D6457-891D-46A8-988D-1FC77627E06A.PNG
