franck18/spacefarm/drive-download-20260924T081925Z-1-001/D8B0E705-63E4-443B-8CA5-B441DF63FC85.PNG

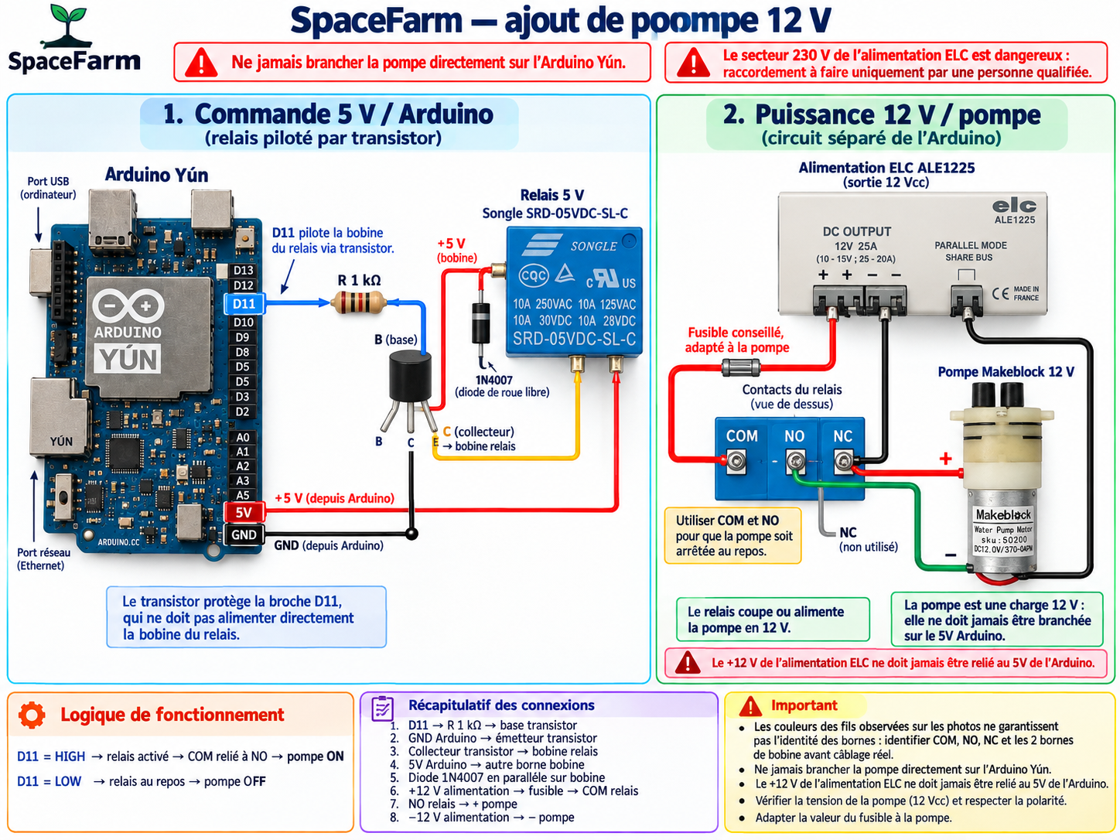
drive-download-20260924T081925Z-1-001/D8B0E705-63E4-443B-8CA5-B441DF63FC85.PNG
