franck18/spacefarm/drive-download-20260924T081925Z-1-001/IMG_4005.JPG

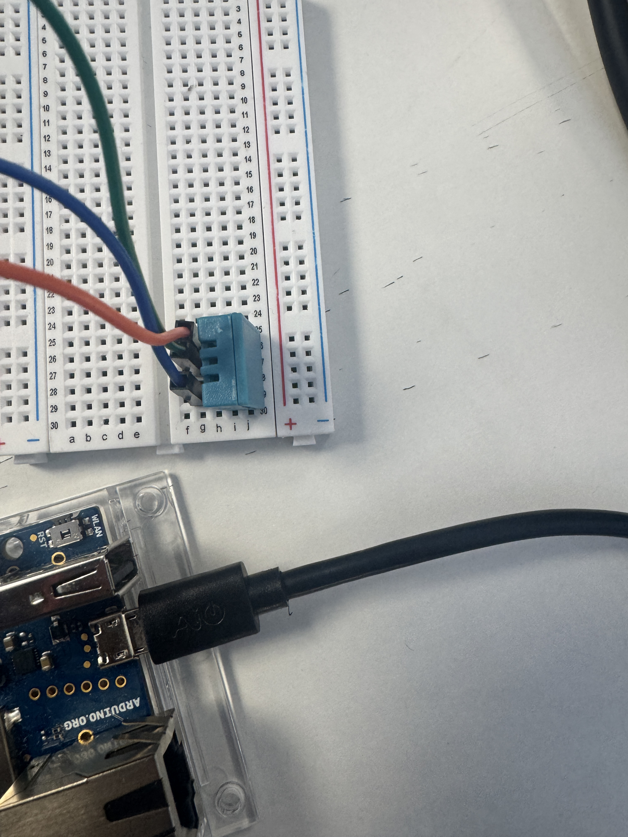
drive-download-20260924T081925Z-1-001/IMG_4005.JPG
