franck18/spacefarm/drive-download-20260924T082003Z-1-001/IMG_4077.JPG

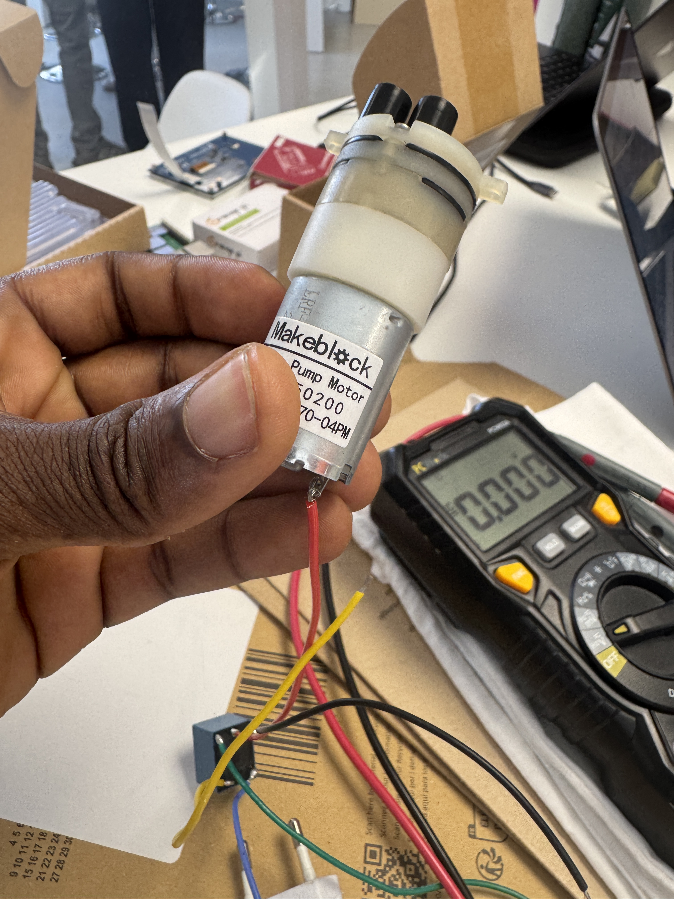
drive-download-20260924T082003Z-1-001/IMG_4077.JPG
